friedeas/grueslesbox-w48/assets/3d_models/W48-usb-c.3mf

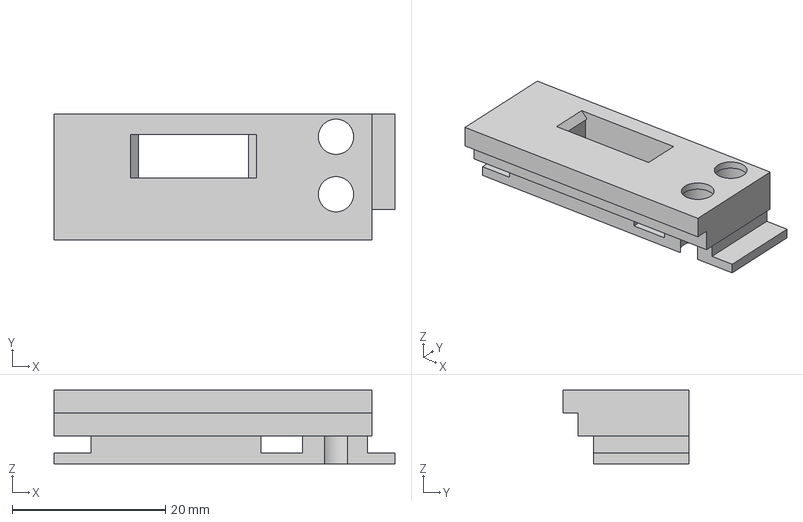
[picture p6: CAD file, 2026-10-11]
assets/3d_models/W48-usb-c.3mf
44.5 x 16.5 x 9.60 mm
