friedeas/grueslesbox-w48/assets/3d_models/w48_raspberry_pi_mount.3mf

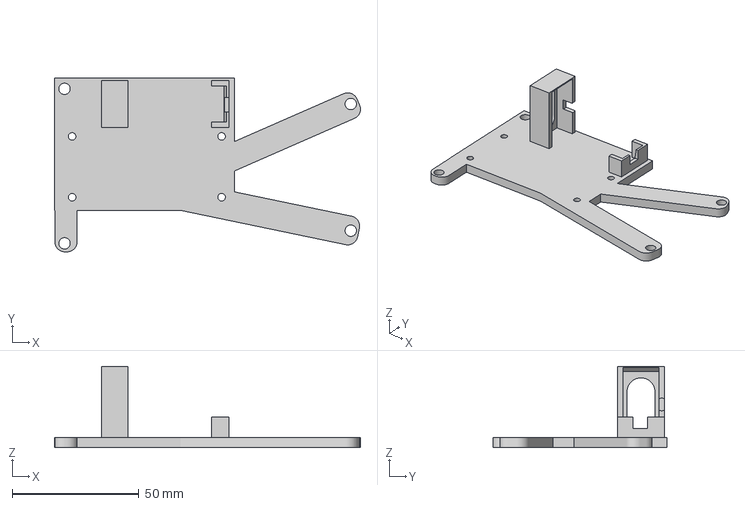
[picture p7: CAD file, 2026-10-11]
assets/3d_models/w48_raspberry_pi_mount.3mf
120.8 x 68.6 x 32.0 mm
