friedeas/grueslesbox-w48/assets/3d_models/mce401_mic_mount.3mf

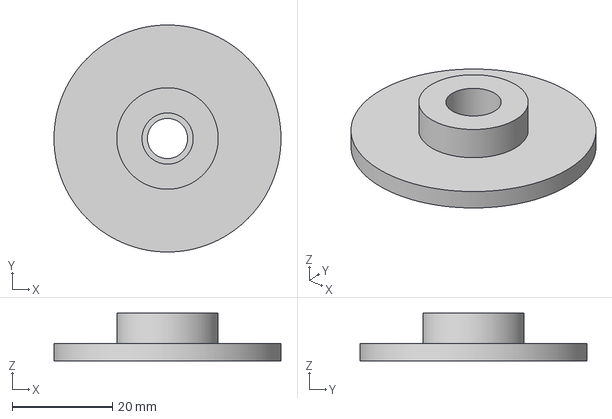
[picture p8: CAD file, 2026-10-11]
assets/3d_models/mce401_mic_mount.3mf
45.2 x 45.2 x 9.50 mm
