friedeas/grueslesbox-w48/(list of files, cad)

Other CAD files:
assets/3d_models/W48-usb-c.f3d
assets/3d_models/mce401_mic_mount.f3d
assets/3d_models/w48_raspberry_pi_mount.f3d
